ussaema/Hand_Gesture_Controlled_Obstacle_Avoiding_Robot/Documentation/Final presentation.pdf

# Oussema Dhaouadi Technical University of Munich Institute for Cognitive Systems (ICS)

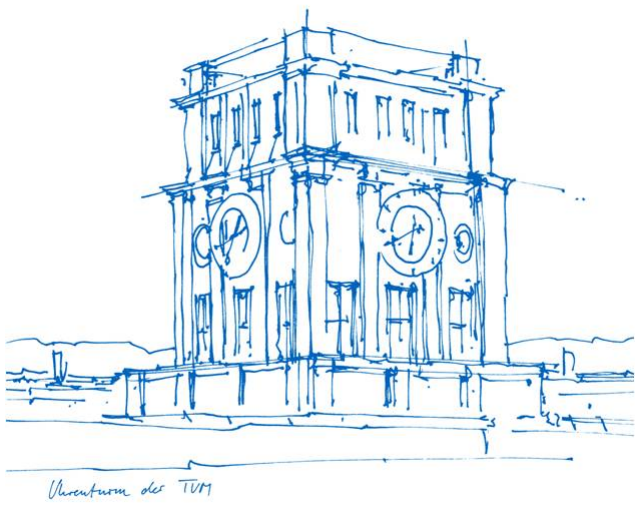
[picture p10: figure]

# July 24th, 2019

# HSA Project: Hand-Gesture-Controlled Obstacle Avoiding Robot with Haptic Feedback

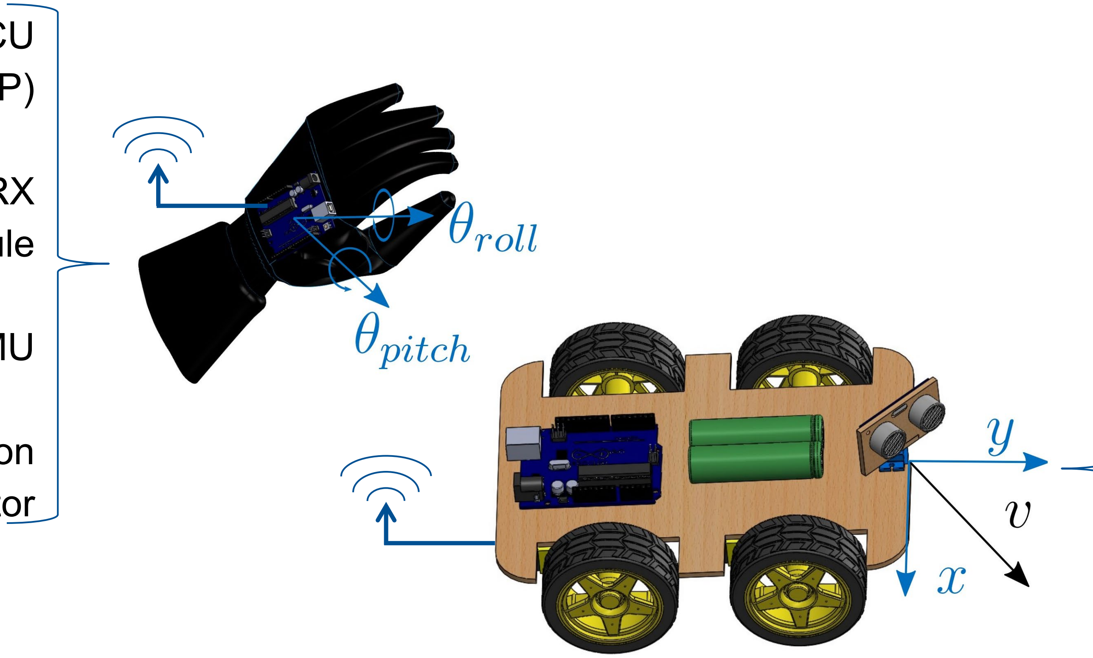
[picture p11: figure]

Oussema Dhaouadi | Humanoid Sensors und Actuators | Institute for Cognitive Systems (ICS) | 2

# Hardware

Chair for Cognitive Systems
Department of Electrical and Computer Engineering Technische Universität München

# MCU (Atmega328P)

# Radio TX/RX module

# 6Dof IMU

# Vibration Motor

# MCU (Atmega328P)

# Radio TX/RX module

# Ultrasonic sensor

# Infrared sensors

# Servo

# Gear Motors H-Bridge

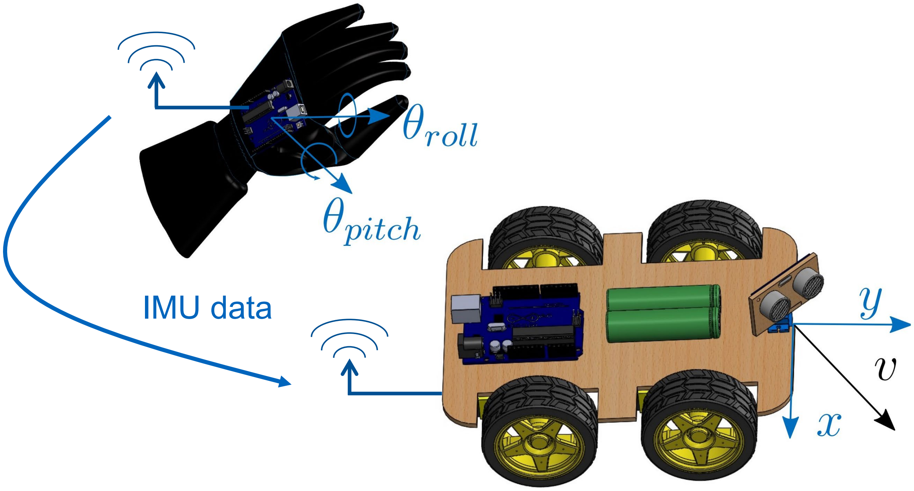
[picture p12: figure]
IMU data

Oussema Dhaouadi | Humanoid Sensors und Actuators | Institute for Cognitive Systems (ICS) | 3

# System Operation

Technische Universität München

# System Operation

# Vibrations

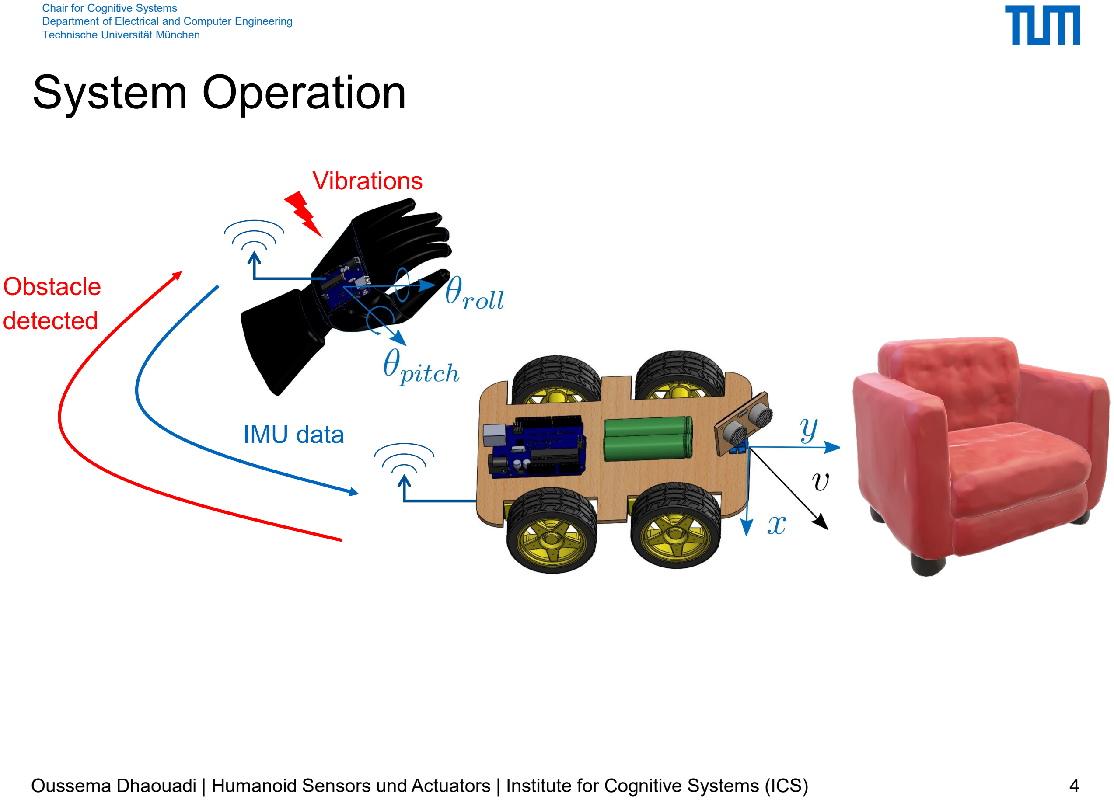
[picture p13: page 4]

Oussema Dhaouadi | Humanoid Sensors und Actuators | Institute for Cognitive Systems (ICS) | 4

Technische Universität München

# Obstacle detected

# IMU data

# Controlled Unit: Obstacle Avoiding Robot

# Ultrasonic sensor:

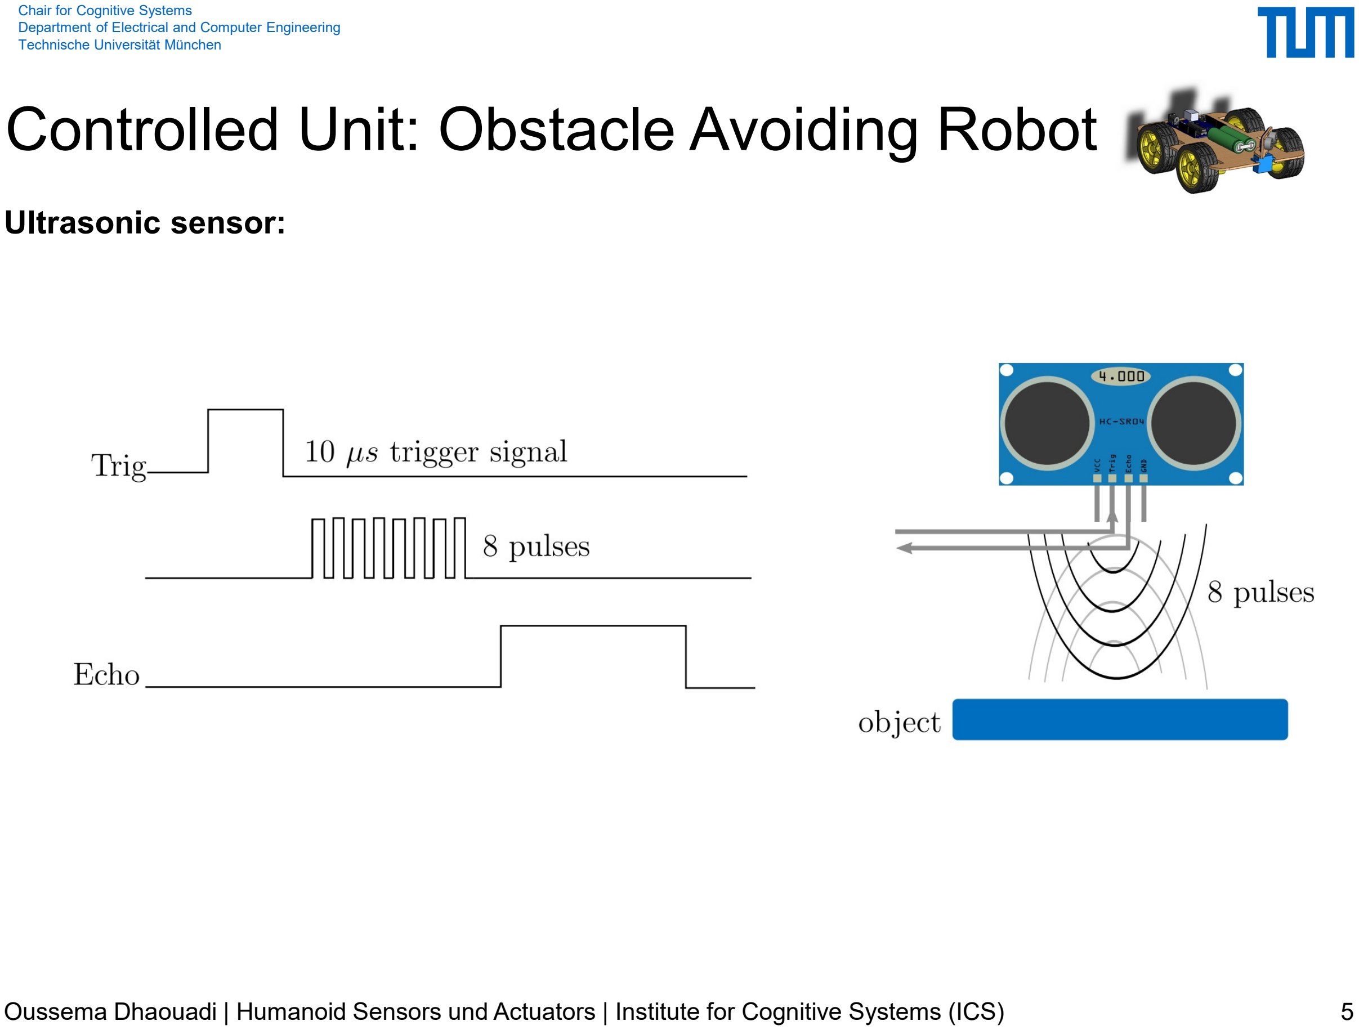
[picture p14: page 5]

Oussema Dhaouadi | Humanoid Sensors und Actuators | Institute for Cognitive Systems (ICS) | 5

Technische Universität München

# Controlled Unit: Obstacle Avoiding Robot

# Ultrasonic sensor:

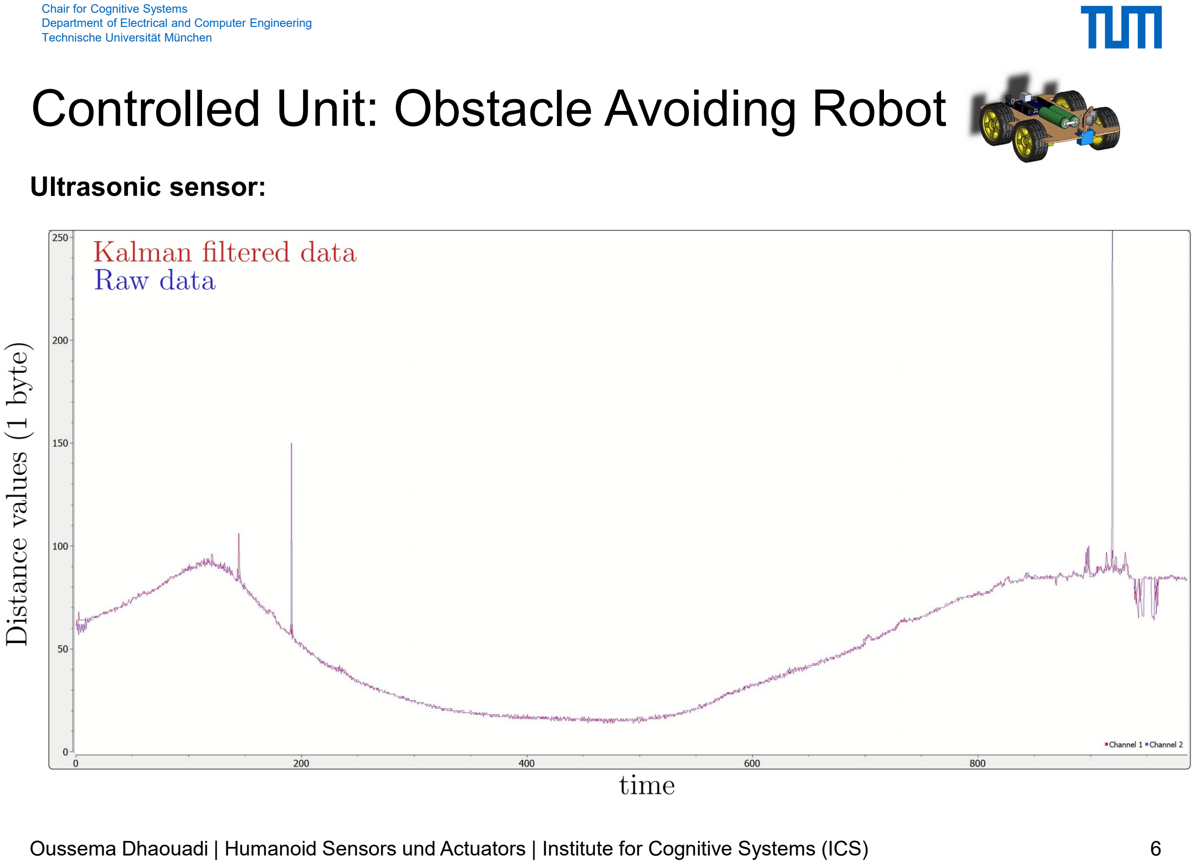
[picture p15: page 6]

Oussema Dhaouadi | Humanoid Sensors und Actuators | Institute for Cognitive Systems (ICS) | 6

Technische Universität München

# Controlled Unit: Obstacle Avoiding Robot

# Servo:

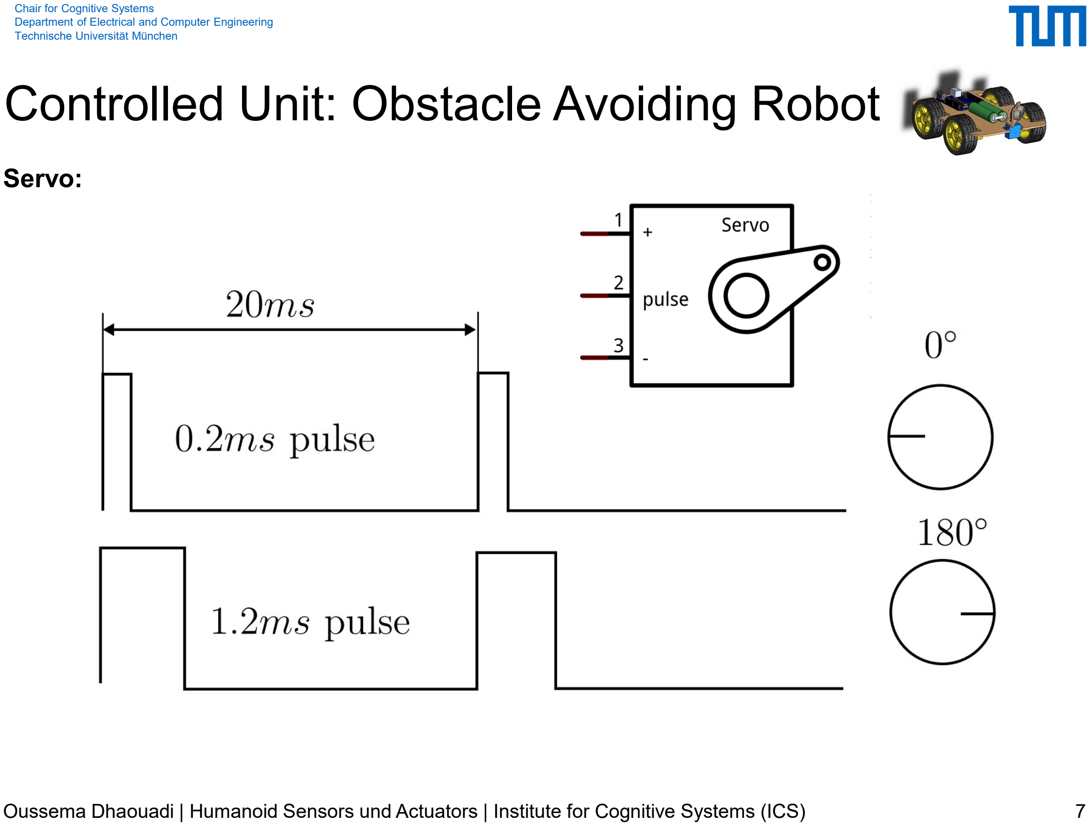
[picture p16: page 7]

Oussema Dhaouadi | Humanoid Sensors und Actuators | Institute for Cognitive Systems (ICS) | 7

Technische Universität München

# Control Unit: Smart Hand

# Inertial Measurement Unit

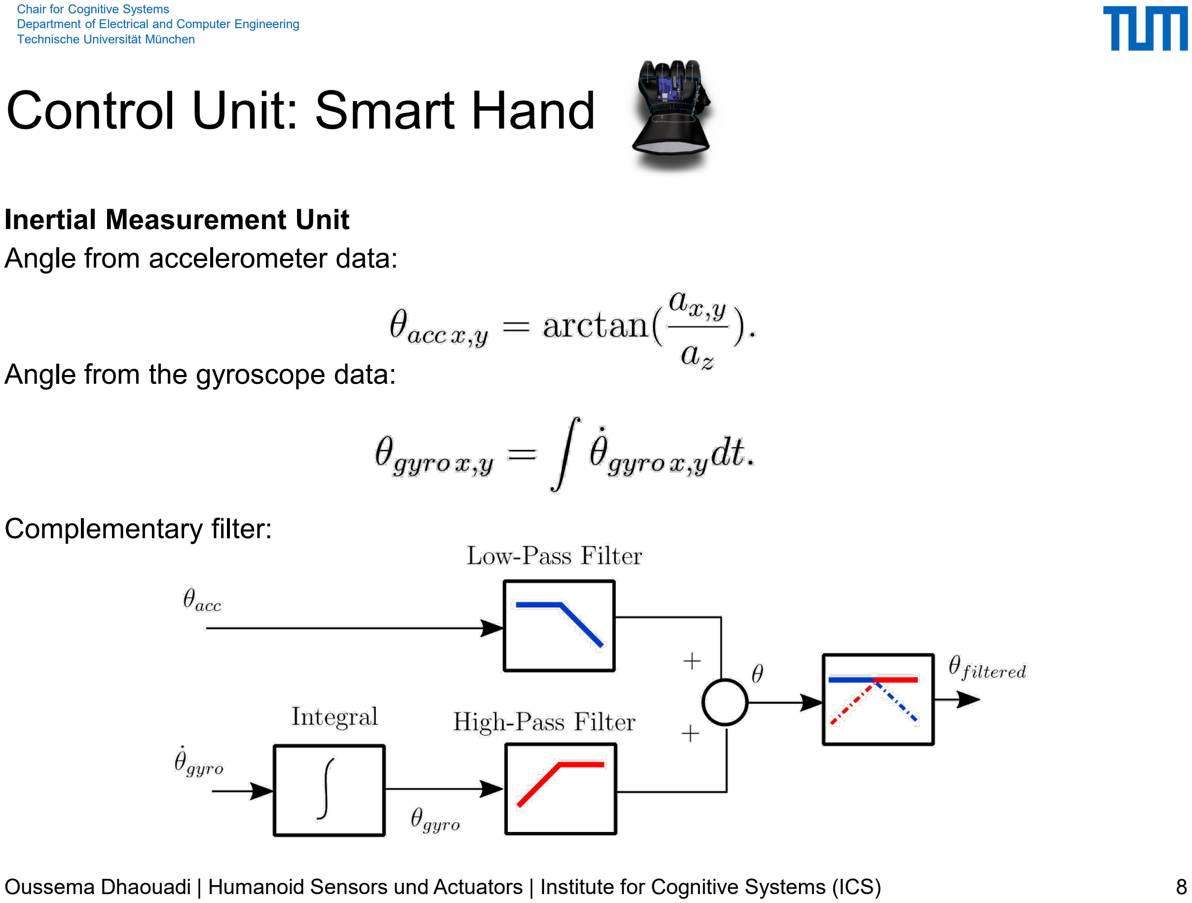
[picture p17: page 8]

Oussema Dhaouadi | Humanoid Sensors und Actuators | Institute for Cognitive Systems (ICS) | 8

# Angle from accelerometer data:

# Angle from the gyroscope data:

# Complementary filter:

Technische Universität München

# Control Unit: Smart Hand

# Inertial Measurement Unit

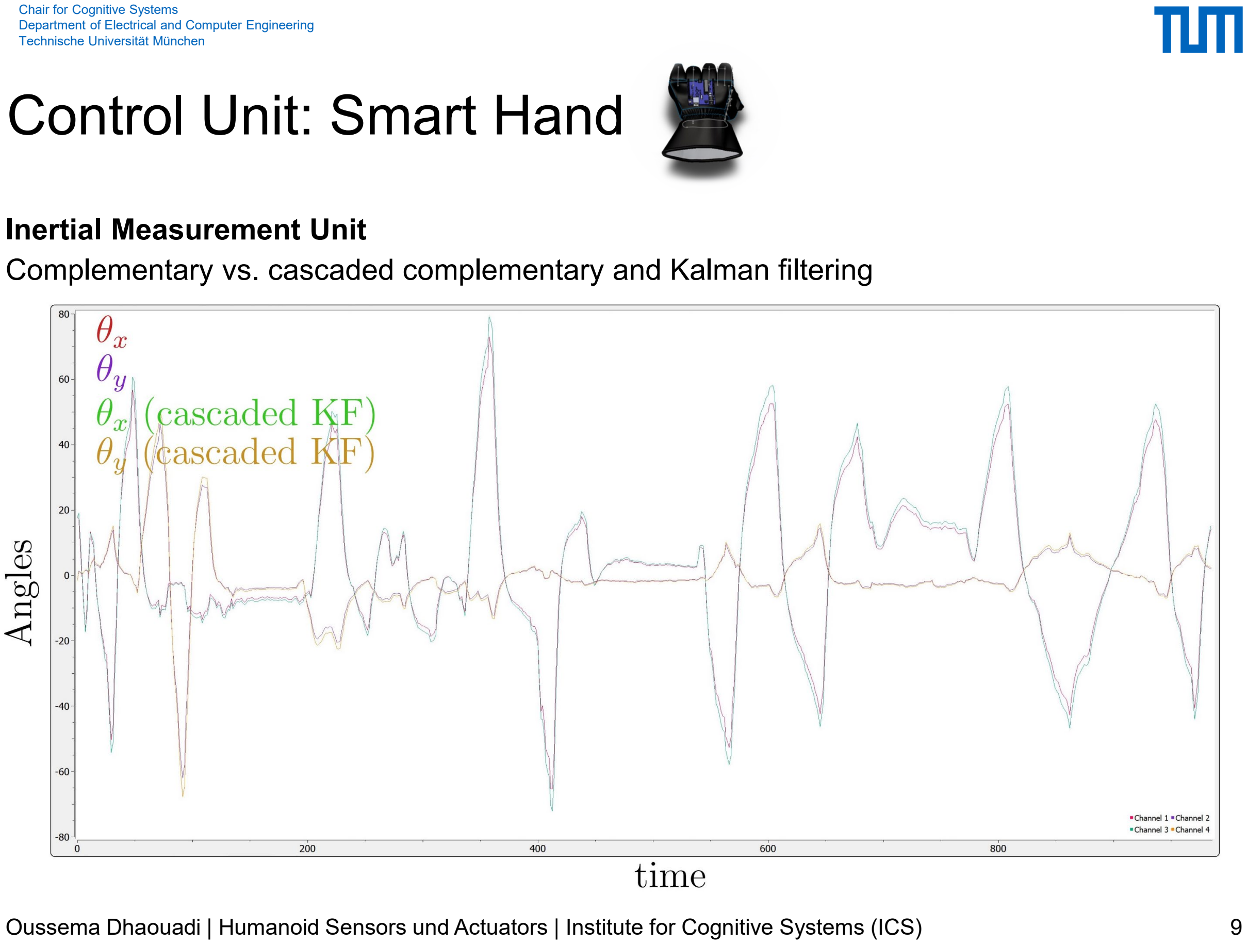
[picture p18: page 9]

Oussema Dhaouadi | Humanoid Sensors und Actuators | Institute for Cognitive Systems (ICS) | 9

# Complementary vs. cascaded complementary and Kalman filtering

Technische Universität München

10

# Thank you for your attention !

Technische Universität München
