ussaema/Hand_Gesture_Controlled_Obstacle_Avoiding_Robot/Documentation/First presentation.pdf

Oussema Dhaouadi

Technical University of Munich

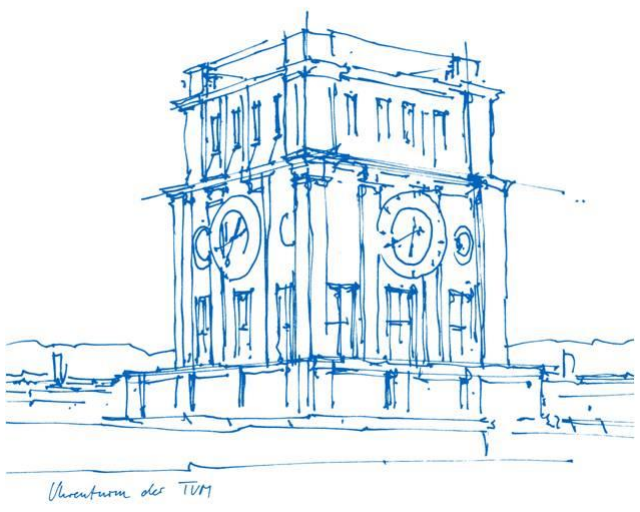
[picture p19: figure]

Institute for Cognitive Systems (ICS)

June 14th, 2019

# HSA Project: Hand-Gesture-Controlled Obstacle Avoiding Robot with Haptic Feedback

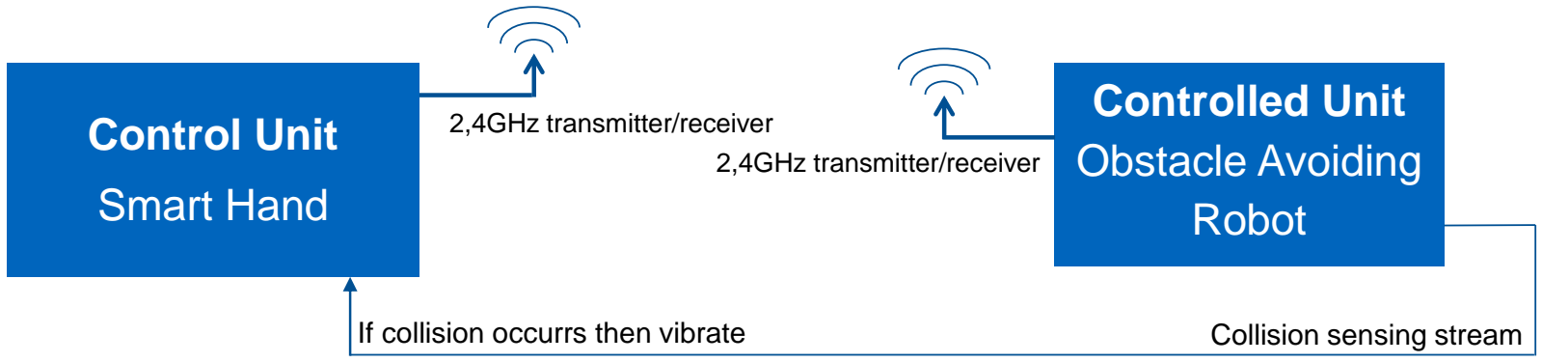
[picture p20: figure]
Controlled Unit Obstacle Avoiding Robot; Control Unit; Smart Hand; 2,4GHz transmitter/receiver; If collision occurrs then vibrate; Collision sensing stream

Oussema Dhaouadi | Humanoid Sensors und Actuators | Institute for Cognitive Systems (ICS) | 2

# Overview

TX:
- Gesture-based motions are translated into control commands.
Channel:
- Air – Range up to 100m.
RX:
- Collisions feedback commands are translated into haptic vibrations and increases user’s sense of presence and agency.

RX:
- Control commands are translated into actions (rotations and translations). Channel:
- Air - Range up to 100m.
TX:
- Collisions are translated into feedback commands.

Chair for Cognitive Systems
Department of Electrical and Computer Engineering Technische Universität München

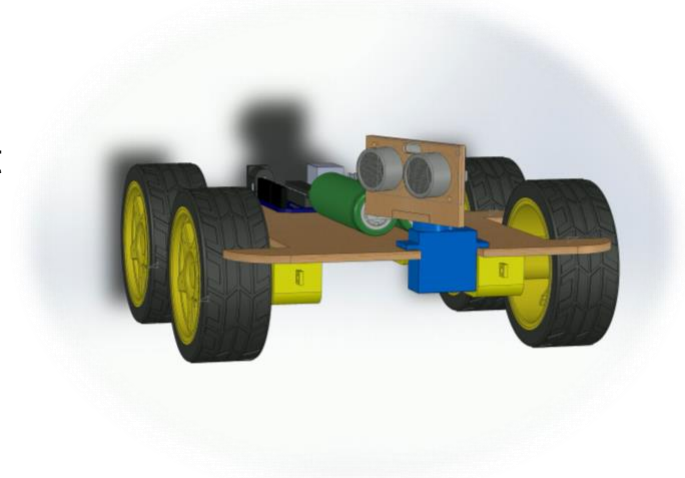
[picture p21: figure]

Oussema Dhaouadi | Humanoid Sensors und Actuators | Institute for Cognitive Systems (ICS) | 3

# Controlled Unit: Obstacle Avoiding Robot

Features
- Body: A Chassis
- Brain: MCU (ATmega328P – Arduino UNO/Nano)
- Transmitter: NRF24L01 2.4GHz - 100m range
- Sensors:
- Ultrasonic sensor (HC-SR04): distance estimator.
- 3x Infrared sensors (SN-IRS-01): distance estimators for the right, left and back sides.
- Actuators:
- Servo (SG90) : Head rotator (180°)
- 4x Gear Motors with one driver (L298N) (includes H-Bridge, which provides the ability to fully control the left and right-side wheels).

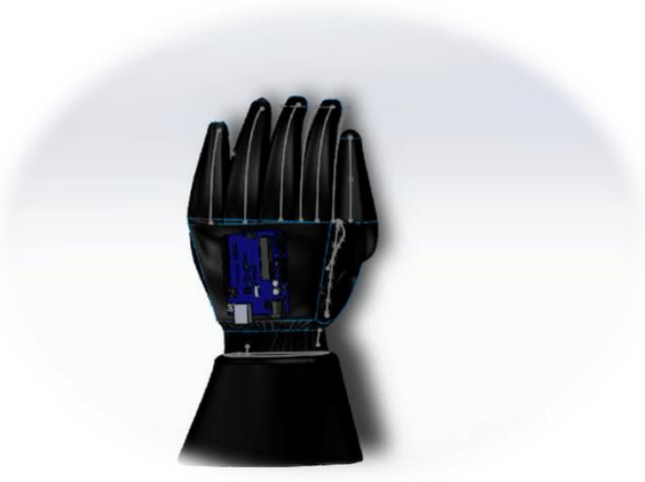
[picture p22: figure]
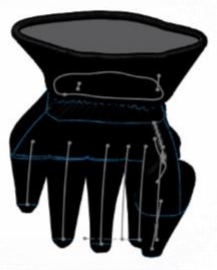
[picture p23: figure]
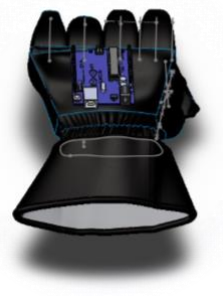
[picture p24: figure]
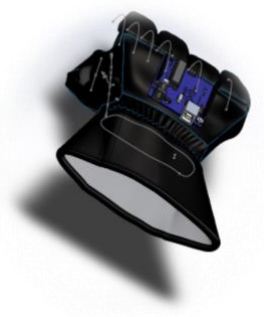
[picture p25: figure]
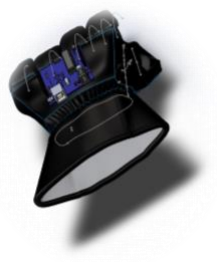
[picture p26: figure]

Oussema Dhaouadi | Humanoid Sensors und Actuators | Institute for Cognitive Systems (ICS) | 4

# Control Unit: Smart Hand

Features
- Body: Glove
- Brain: MCU (ATmega328P – Arduino UNO/Nano)
- Transmitter: NRF24L01 2.4GHz - 100m range
- Sensors:
- 6DoF Gyroscope (GY-521 MPU-6050).
- Actuators:
- Vibration Motor: used to sense collisions as feedback.
move to the left | move to the right | move forwards | move backwards

5

# Thank you for your attention !
