ussaema/Hand_Gesture_Controlled_Obstacle_Avoiding_Robot/Project/include/Utility.h

/*
 * Utility.h
 *
 * Created: 10.07.2019 17:40:35
 *  Author: ussaema
 */ 


#ifndef UTILITY_H_
#define UTILITY_H_
#include "stdlib.h"

// Linear interpolation
float linear_mapping(float intput, float min_input, float max_input, float min_output, float max_output);


#endif /* UTILITY_H_ */
